ExploreEmbedded/8051_ExploreStarter8051/(list of files, cad)

Other CAD files:
Code/KeilSampleCodes/01a-LedBlinking/Objects/main.obj
Code/KeilSampleCodes/02a-SwitchLed/Objects/main.obj
Code/KeilSampleCodes/05b-Lcd_4bit_UpCounter/Objects/main.obj
Code/KeilSampleCodes/06c-UART_Tx_String/Objects/main.obj
Code/KeilSampleCodes/06d-UART_Tx_Numbers/Objects/main.obj
Code/KeilSampleCodes/06e-UART_String_RxTx_Lcd/Objects/main.obj
Code/KeilSampleCodes/09b-RTC_DS1307_LCD/Objects/main.obj
Code/KeilSampleCodes/05a-Lcd_4bit_Display/Objects/main.obj
Code/KeilSampleCodes/05c-Lcd_4bit_Scrolling/Objects/main.obj
Code/KeilSampleCodes/06a_UART_Tx_Char/Objects/main.obj
Code/KeilSampleCodes/07a-ADC_UART/Objects/main.obj
Code/KeilSampleCodes/Starter8051BoardTest/Objects/main.obj
Code/KeilSampleCodes/07b-Adc_RawValue_Voltage/Objects/main.obj
Code/KeilSampleCodes/07c-ADC_LM35_TempSensor/Objects/main.obj
Code/KeilSampleCodes/07e-ADC_Temperature_LCD/Objects/main.obj
Code/KeilSampleCodes/09a-RTC_DS1307_UART/Objects/main.obj
Code/KeilSampleCodes/10a-GLcd_Test/main.OBJ
Code/KeilSampleCodes/06b-UART_Rx_Tx_Lcd/Objects/main.obj
Code/KeilSampleCodes/07d-ADC_LCD/Objects/main.obj
Code/KeilExampleCodes/01a-LedBlinking_Example/01a-LedBlinking_Example.OBJ
Code/KeilExampleCodes/02a-SwitchLed_Example/02a-SwitchLed_Example.OBJ
Code/KeilExampleCodes/05a-Lcd_4bit_Display/gpio.obj
Code/KeilSampleCodes/05a-Lcd_4bit_Display/Objects/lcd.obj
Code/KeilSampleCodes/05c-Lcd_4bit_Scrolling/Objects/lcd.obj
Code/KeilSampleCodes/06a_UART_Tx_Char/Objects/delay.obj
Code/KeilSampleCodes/06b-UART_Rx_Tx_Lcd/Objects/delay.obj
Code/KeilSampleCodes/06e-UART_String_RxTx_Lcd/Objects/uart.obj
Code/KeilSampleCodes/07a-ADC_UART/Objects/uart.obj
Code/KeilSampleCodes/07b-Adc_RawValue_Voltage/Objects/uart.obj
Code/KeilSampleCodes/07c-ADC_LM35_TempSensor/Objects/adc.obj
Code/KeilSampleCodes/07d-ADC_LCD/Objects/adc.obj
Code/KeilSampleCodes/07e-ADC_Temperature_LCD/Objects/lcd.obj
Code/KeilSampleCodes/09a-RTC_DS1307_UART/Objects/i2c.obj
Code/KeilSampleCodes/09b-RTC_DS1307_LCD/Objects/gpio.obj
Code/KeilSampleCodes/10a-GLcd_Test/glcd.obj
Code/KeilSampleCodes/Starter8051BoardTest/Objects/lcd.obj
Code/KeilExampleCodes/05a-Lcd_4bit_Display/delay.obj
Code/KeilSampleCodes/05a-Lcd_4bit_Display/Objects/delay.obj
Code/KeilSampleCodes/05b-Lcd_4bit_UpCounter/Objects/lcd.obj
Code/KeilSampleCodes/05c-Lcd_4bit_Scrolling/Objects/gpio.obj
Code/KeilSampleCodes/06a_UART_Tx_Char/Objects/uart.obj
Code/KeilSampleCodes/06b-UART_Rx_Tx_Lcd/Objects/lcd.obj
Code/KeilSampleCodes/06c-UART_Tx_String/Objects/uart.obj
Code/KeilSampleCodes/06d-UART_Tx_Numbers/Objects/uart.obj
Code/KeilSampleCodes/07a-ADC_UART/Objects/delay.obj
Code/KeilSampleCodes/07b-Adc_RawValue_Voltage/Objects/adc.obj
Code/KeilSampleCodes/07c-ADC_LM35_TempSensor/Objects/delay.obj
Code/KeilSampleCodes/07d-ADC_LCD/Objects/lcd.obj
Code/KeilSampleCodes/07e-ADC_Temperature_LCD/Objects/gpio.obj
Code/KeilSampleCodes/09a-RTC_DS1307_UART/Objects/rtc.obj
Code/KeilSampleCodes/10a-GLcd_Test/logo.obj
Code/KeilSampleCodes/Starter8051BoardTest/Objects/gpio.obj
Code/KeilExampleCodes/05a-Lcd_4bit_Display/lcd.obj
Code/KeilSampleCodes/05b-Lcd_4bit_UpCounter/Objects/gpio.obj
Code/KeilSampleCodes/06b-UART_Rx_Tx_Lcd/Objects/gpio.obj
Code/KeilSampleCodes/06d-UART_Tx_Numbers/Objects/delay.obj
Code/KeilSampleCodes/06e-UART_String_RxTx_Lcd/Objects/gpio.obj
Code/KeilSampleCodes/07b-Adc_RawValue_Voltage/Objects/delay.obj
Code/KeilSampleCodes/07c-ADC_LM35_TempSensor/Objects/uart.obj
Code/KeilSampleCodes/07d-ADC_LCD/Objects/delay.obj
Code/KeilSampleCodes/07e-ADC_Temperature_LCD/Objects/adc.obj
Code/KeilSampleCodes/09a-RTC_DS1307_UART/Objects/delay.obj
Code/KeilSampleCodes/09b-RTC_DS1307_LCD/Objects/lcd.obj
Code/KeilSampleCodes/10a-GLcd_Test/delay.obj
Code/KeilExampleCodes/05a-Lcd_4bit_Display/05a-Lcd_4bit_Display.OBJ
Code/KeilSampleCodes/05a-Lcd_4bit_Display/Objects/gpio.obj
Code/KeilSampleCodes/05b-Lcd_4bit_UpCounter/Objects/delay.obj
Code/KeilSampleCodes/05c-Lcd_4bit_Scrolling/Objects/delay.obj
Code/KeilSampleCodes/06a_UART_Tx_Char/Objects/lcd.obj
Code/KeilSampleCodes/06b-UART_Rx_Tx_Lcd/Objects/uart.obj
Code/KeilSampleCodes/06e-UART_String_RxTx_Lcd/Objects/delay.obj
Code/KeilSampleCodes/07a-ADC_UART/Objects/adc.obj
Code/KeilSampleCodes/07d-ADC_LCD/Objects/gpio.obj
Code/KeilSampleCodes/09b-RTC_DS1307_LCD/Objects/delay.obj
Code/KeilSampleCodes/Starter8051BoardTest/Objects/uart.obj
Code/KeilSampleCodes/06a_UART_Tx_Char/Objects/gpio.obj
Code/KeilSampleCodes/06e-UART_String_RxTx_Lcd/Objects/lcd.obj
Code/KeilSampleCodes/07e-ADC_Temperature_LCD/Objects/delay.obj
Code/KeilSampleCodes/09a-RTC_DS1307_UART/Objects/uart.obj
Code/KeilSampleCodes/09b-RTC_DS1307_LCD/Objects/i2c.obj
Code/KeilSampleCodes/10a-GLcd_Test/uart.OBJ
Code/KeilSampleCodes/Starter8051BoardTest/Objects/delay.obj
Code/KeilSampleCodes/09b-RTC_DS1307_LCD/Objects/rtc.obj
