ExploreEmbedded/8051_ExploreStarter8051/Design Files/Starter_x51_USB.pdf

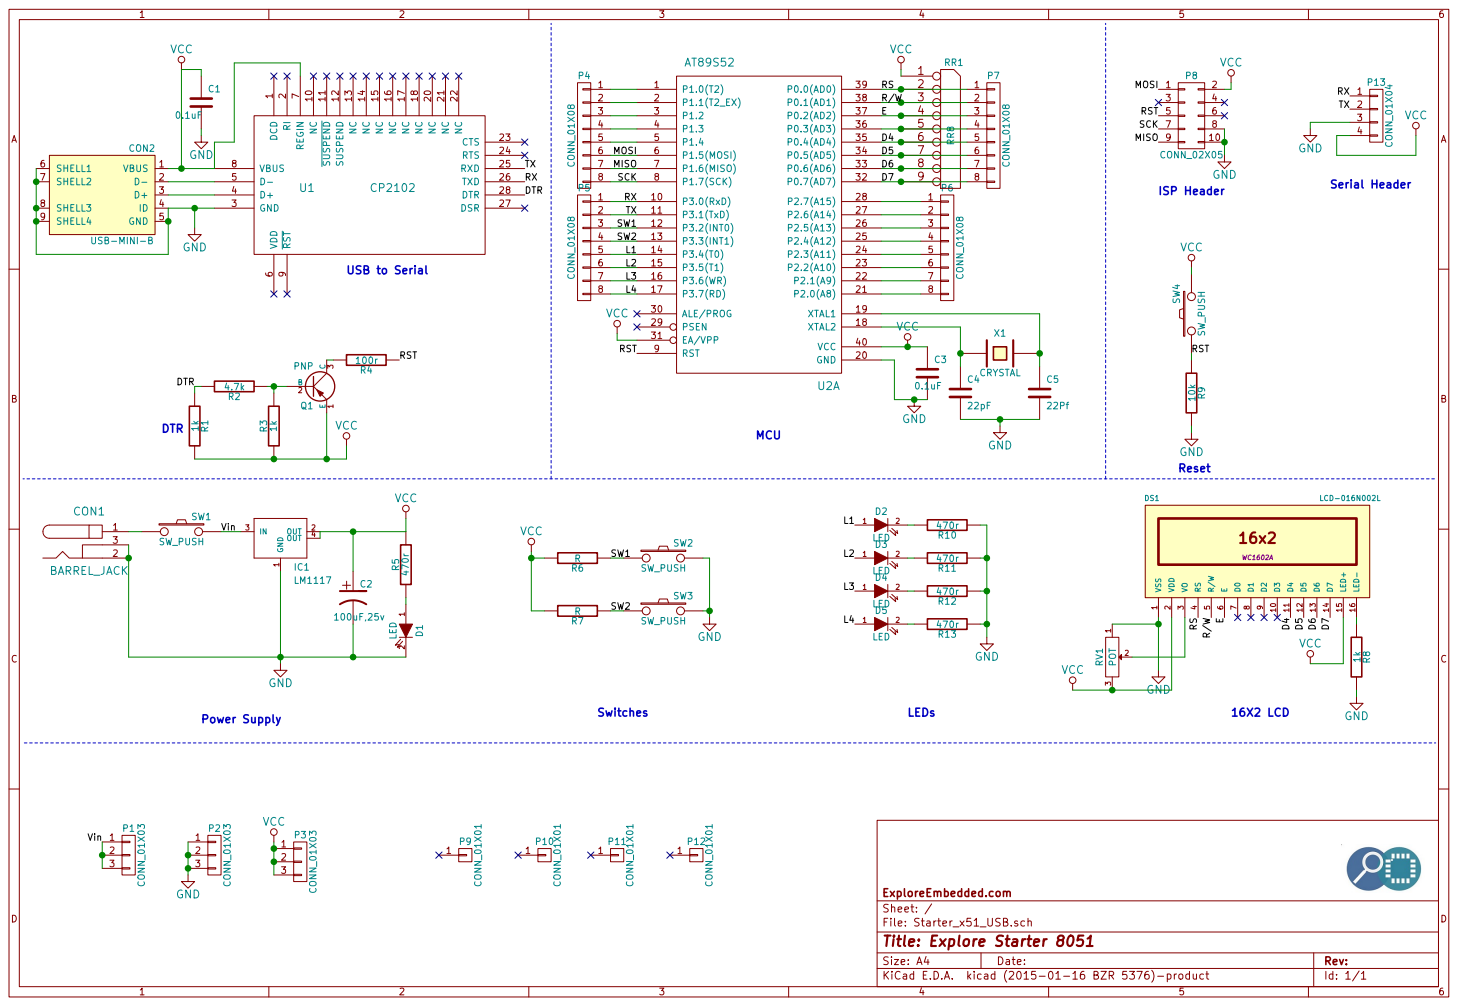
[picture p1: page 1]

9 NC 10 NC 20 SUSPEND 11 NC 21 SUSPEND 12 NC 22 NC 13 CTS 23 NC 14 RTS 24 NC 15 RXD 25 NC 16 TXD 26 NC 17 DSR 27 NC 18 DTR U1 CP2102 28 VBUS 1 D- 2 D+ 3

USB to Serial DTR

3 Q1 PNP Power Supply Switches LEDs 16X2 LCD

9 D3 10 D4 11 D5 12 D6 13 D7 14 LED+ 15 LED- 16 DS1 LCD-016N002L WC1602A GND

File: Starter_x51_USB.sch Sheet: / ExploreEmbedded.com

Id: 1/1 Title: Explore Starter 8051
