ExploreEmbedded/8051_ExploreStarter8051/(list of files, drawings)

Other design files:
Other/Tutorials fritzing diagram/7segment.fzz
