ExploreEmbedded/8051_ExploreStarter8051/Design Files/Starter_x51_USB.kicad_pcb

## KiCad design Design Files/Starter_x51_USB.kicad_pcb (2016-03-23)

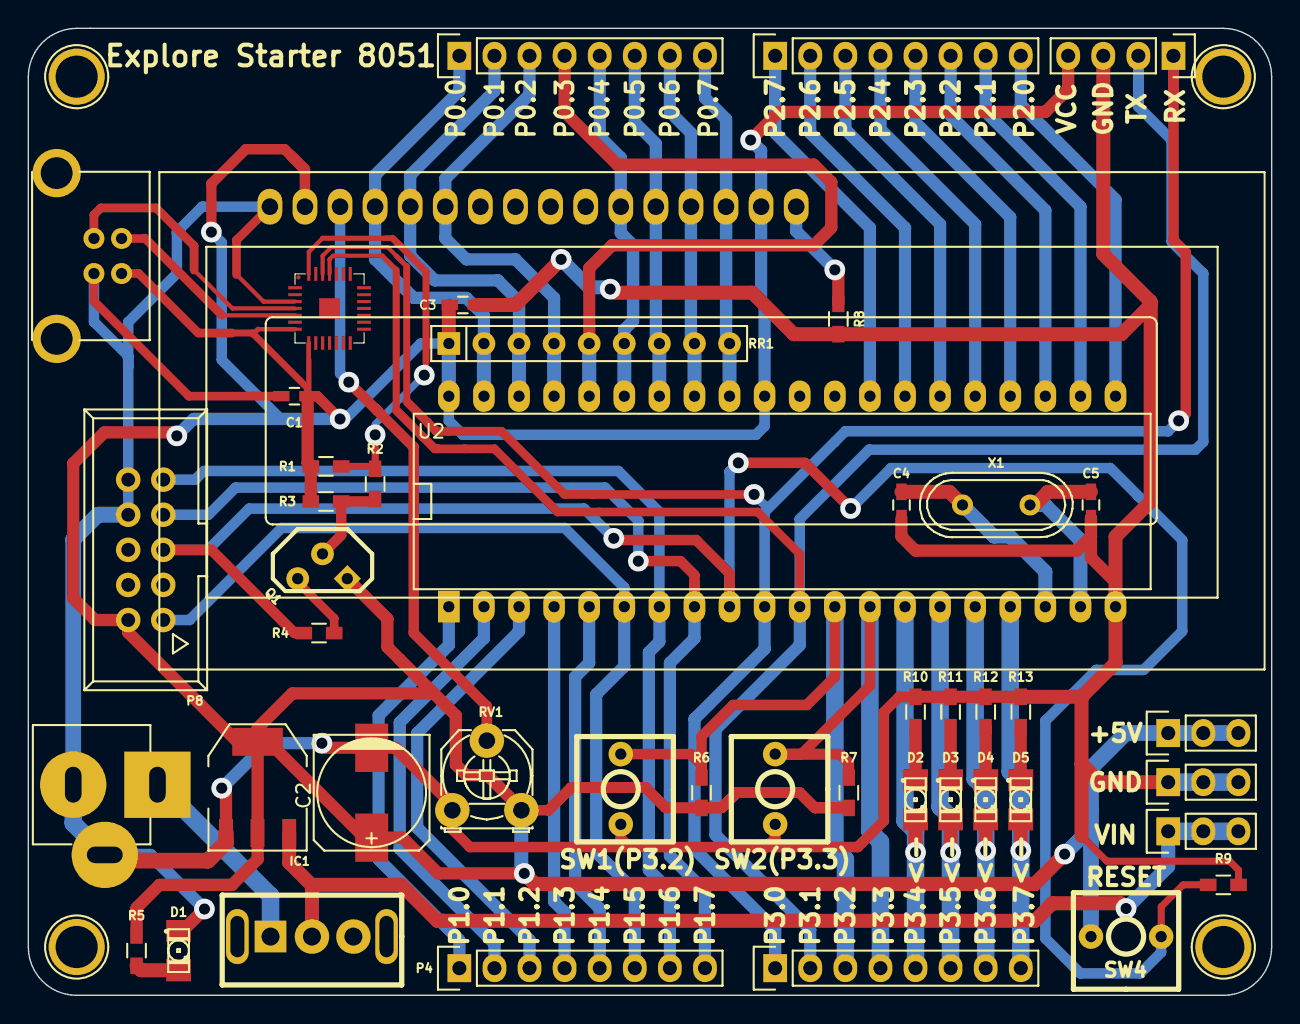
[picture p2: board Starter_x51_USB.kicad_pcb from above]

Board: 2 copper layers, 90.0 x 70.0 mm, 50 parts (0 on the bottom side), 51 nets.

Parts:
C1, C3: 0.1uF; C_0603_HandSoldering
C2: 100uF,25v; c_elec_8x10.5
C4: 22pF; C_0603_HandSoldering
C5: 22Pf; C_0603_HandSoldering
CON1: BARREL_JACK; JACK_ALIM
CON2: USB-MINI-B; USB_B
D1, D2, D3, D4, D5: LED; LED-1206_NEW
DS1: LCD-016N002L; WC1602A
IC1: LM1117; LM_1117
P1, P2, P3: CONN_01X03; Pin_Header_Straight_1x03
P4, P5, P6, P7: CONN_01X08; Pin_Header_Straight_1x08
P8: CONN_02X05; VASCH5x2
P9, P10, P11, P12: CONN_01X01; 1pin
P13: CONN_01X04; Pin_Header_Straight_1x04
Q1: PNP; BC557
R1, R3, R8: 1k; R_0603_HandSoldering
R2: 4.7k; R_0603_HandSoldering
R4: 100r; R_0603_HandSoldering
R5, R10, R11, R12, R13: 470r; R_0603_HandSoldering
R6, R7: R; R_0603_HandSoldering
R9: 10k; R_0603_HandSoldering
RR1: RR8; Resistor_Array_SIP8
RV1: POT; Potentiometer_Triwood_RM-065
SW1: SW_PUSH; SPSPT_XL_NEW
SW2, SW3, SW4: SW_PUSH; SW_PUSH_SMALL_2pin_3D_xl
U1: CP2102; cp2102_xl2
U2: AT89S52; DIP-40__600_ELL
X1: CRYSTAL; Crystal_HC49-U_Vertical

Connections:
/D4: DS1.11, P7.5, RR1.6, U2.35
/D5: DS1.12, P7.6, RR1.7, U2.34
/D6: DS1.13, P7.7, RR1.8, U2.33
/D7: DS1.14, P7.8, RR1.9, U2.32
/DTR: R1.1, R2.2, U1.28
/E: DS1.6, P7.3, RR1.4, U2.37
/L1: D2.1, P5.5, U2.14
/L2: D3.1, P5.6, U2.15
/L3: D4.1, P5.7, U2.16
/L4: D5.1, P5.8, U2.17
/MISO: P4.7, P8.9, U2.7
/MOSI: P4.6, P8.1, U2.6
/R/W: DS1.5, P7.2, RR1.3, U2.38
/RS: DS1.4, P7.1, RR1.2, U2.39
/RST: P8.5, R4.1, R9.1, SW4.1, U2.9
/RX: P5.1, P13.1, U1.26, U2.10
/SCK: P4.8, P8.7, U2.8
/SW1: P5.3, R6.1, SW2.1, U2.12
/SW2: P5.4, R7.1, SW3.1, U2.13
/TX: P5.2, P13.2, U1.25, U2.11
/Vin: IC1.3, P1.1, P1.2, P1.3, SW1.2
GND: C1.2, C2.2, C3.2, C4.2, C5.2, CON1.2, CON1.3, CON2.4, D1.2, DS1.1, IC1.1, P2.1, P2.2, P2.3, P8.8, P8.10, P13.3, R8.2, R9.2, R10.1, R11.1, R12.1, R13.1, RV1.1, SW2.2, SW3.2, U1.3, U2.20
unnamed: C4.1, U2.18, X1.1
unnamed: C5.1, U2.19, X1.2
unnamed: CON1.1, SW1.1
unnamed: CON2.2, U1.5
unnamed: CON2.3, U1.4
unnamed: D1.1, R5.1
unnamed: D2.2, R10.2
unnamed: D3.2, R11.2
unnamed: D4.2, R12.2
unnamed: D5.2, R13.2
unnamed: DS1.3, RV1.2
unnamed: DS1.16, R8.1
unnamed: P4.1, U2.1
unnamed: P4.2, U2.2
unnamed: P4.3, U2.3
unnamed: P4.4, U2.4
unnamed: P4.5, U2.5
unnamed: P6.1, U2.28
unnamed: P6.2, U2.27
unnamed: P6.3, U2.26
unnamed: P6.4, U2.25
unnamed: P6.5, U2.24
unnamed: P6.6, U2.23
unnamed: P6.7, U2.22
unnamed: P6.8, U2.21
unnamed: P7.4, RR1.5, U2.36
unnamed: Q1.2, R2.1, R3.2
unnamed: Q1.3, R4.2
VCC: C1.1, C2.1, C3.1, CON2.1, DS1.2, DS1.15, IC1.2, IC1.4, P3.1, P3.2, P3.3, P8.2, P13.4, Q1.1, R1.2, R3.1, R5.2, R6.2, R7.2, RR1.1, RV1.3, SW4.2, U1.7, U1.8, U2.31, U2.40
