ExploreEmbedded/8051_ExploreStarter8051/Code/KeilSampleCodes/07e-ADC_Temperature_LCD/main.c

/***************************************************************************************************
                                   ExploreEmbedded
****************************************************************************************************
 * File:   main.c
 * Version: 16.0
 * Author: ExploreEmbedded
 * Website: http://www.exploreembedded.com/wiki
 * Description: This file contains the program to read the temperature(LM35) from ADC channel 0 and display it on LCD.

The libraries have been tested on ExploreEmbedded development boards. We strongly believe that the
library works on any of development boards for respective controllers. However, ExploreEmbedded
disclaims any kind of hardware failure resulting out of usage of libraries, directly or indirectly.
Files may be subject to change without prior notice. The revision history contains the information
related to updates.


GNU GENERAL PUBLIC LICENSE:
    Copyright (C) 2012  ExploreEmbedded

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

Errors and omissions should be reported to codelibraries@exploreembedded.com
**************************************************************************************************/
#include "adc.h"
#include "lcd.h"

/********************************
  adc.h ADC0809 pin Connections
*********************************
adc_databus --> P2

adc_A    --> P1^0;
adc_B    --> P1^1;
adc_C    --> P1^2;
adc_ALE  --> P1^3;
adc_Start--> P1^4;
adc_EOC  --> P1^5;
adc_OE   --> P1^6;
*********************************/ 

int main() 
{
    int adcValue;
    int temp;
    
    ADC_Init();       /* Initialize the ADC module */
    
    /*Connect RS->P0.0, RW->P0.1, EN->P0.2 and data bus to P0.4 to P0.7*/
    LCD_SetUp(P0_0,P0_1,P0_2,P_NC,P_NC,P_NC,P_NC,P0_4,P0_5,P0_6,P0_7);
    LCD_Init(2,16);
    
    while(1)
    {
        adcValue = ADC_GetAdcValue(0); // Read the ADC value of channel zero where the temperature sensor(LM35) is connected
        
        /* Convert the raw ADC value to equivalent temperature with 5v as ADC reference
		       Step size of AdC= (5v/255)=19.60mv = 20mv.
		       for every degree celcius the Lm35 provides 10mv voltage change.
			     1 step of ADC=20mv=2'c, hence the Raw ADC value can be multiplied by 2 to get equivalent temp*/
        
        temp = adcValue*2; // Multiple by 2 to get the temp value.
        LCD_GoToLine(0);
        LCD_Printf("ADC0 Value:%3d \nTemp:%2d\n\r",adcValue,temp);     // Display adc value and temp LCD
    }
    
    return (0);
}
