ExploreEmbedded/8051_ExploreStarter8051/Code/KeilSampleCodes/00-libfiles/logo.c

/***************************************************************************************************
                                    ExploreEmbedded Copyright Notice    
*****************************************************************************************************
 * File:   logo.c
 * Version: 16.0
 * Author: ExploreEmbedded
 * Website: http://www.exploreembedded.com/wiki
 * Description: File contains the bitmap for sample Logos.
 * Note: The logos are just for demo purpose and all rights pertaining to these belong to the respective owners.

This code has been developed and tested on ExploreEmbedded boards.  
We strongly believe that the library works on any of development boards for respective controllers. 
Check this link http://www.exploreembedded.com/wiki for awesome tutorials on 8051,PIC,AVR,ARM,Robotics,RTOS,IOT.
ExploreEmbedded invests substantial time and effort developing open source HW and SW tools, to support consider buying the ExploreEmbedded boards.
 
The ExploreEmbedded libraries and examples are licensed under the terms of the new-bsd license(two-clause bsd license).
See also: http://www.opensource.org/licenses/bsd-license.php

EXPLOREEMBEDDED DISCLAIMS ANY KIND OF HARDWARE FAILURE RESULTING OUT OF USAGE OF LIBRARIES, DIRECTLY OR
INDIRECTLY. FILES MAY BE SUBJECT TO CHANGE WITHOUT PRIOR NOTICE. THE REVISION HISTORY CONTAINS THE INFORMATION 
RELATED TO UPDATES.
 

Permission to use, copy, modify, and distribute this software and its documentation for any purpose
and without fee is hereby granted, provided that this copyright notices appear in all copies 
and that both those copyright notices and this permission notice appear in supporting documentation.
***************************************************************************************************/

#define _audi_                 0
#define _ford_                 1
#define _puma_                 2
#define _sparx_                3
#define _intel_                5
#define _microsoft_            6
#define _nike_                 7
#define _spartans_             8
#define _tajmahal_1_           9
#define _tajmahal_2_          10
#define _titanic_             11
#define _AshokStambh_         12
#define _Camera_              13
#define _exploreEmbedded_     14
#define _PremierLeage_        15
#define _Arsenal_             16
#define _Chelsea_             17
#define _LiverPool_           18
#define _ManchesterUnited_    19
#define _SouthWalesScorpians_ 20

#define _IPL_                 21
#define _Bengaluru_           22
#define _Delhi_               23
#define _Gujrat_              24
#define _Hyderabad_           25
#define _Kolkata_             26
#define _Mumbai_              27
#define _Punjab_              28
#define _Pune_                29
#define _MakeInIndia_         30
#define _NoLogo_              99


/****************************************************************************
                Select one of the above logos to be displayed
****************************************************************************/								
#define SelectLogo _exploreEmbedded_
/***************************************************************************/





/******************************************************************************************************
                          128x64 BitMap for standard Logos 
*******************************************************************************************************/													
#if (SelectLogo == _audi_)
code const unsigned char LogoBitMap[] = {
  0xFF, 0xFF, 0xFF, 0xFF, 0xFF, 0xFF, 0xFF, 0xFF, 0xFF, 0xFF, 0xFF, 0xFF, 0x7F, 0x3F, 0x1F, 0x8F,
  0x87, 0xC7, 0xC7, 0xE3, 0xE3, 0xF3, 0xF1, 0xF1, 0xF1, 0xF1, 0xF1, 0xF1, 0xF1, 0xF1, 0xF5, 0xF3,
  0xF3, 0xEB, 0xEB, 0xDF, 0xF7, 0xBF, 0x7F, 0x7F, 0x0F, 0x8F, 0xC7, 0xC7, 0xE3, 0xE3, 0xF3, 0xF3,
  0xF1, 0xF1, 0xF1, 0xF1, 0xF1, 0xF1, 0xF1, 0xF1, 0xF3, 0xFB, 0xEB, 0xFF, 0xDF, 0xDF, 0xB7, 0xFF,
  0x5F, 0x8F, 0x87, 0xC7, 0xC7, 0xE3, 0xE3, 0xF3, 0xF1, 0xF1, 0xF1, 0xF1, 0xF1, 0xF1, 0xF1, 0xF1,
  0xF1, 0xFB, 0xFB, 0xEB, 0xFB, 0xDF, 0xFF, 0xBF, 0x7F, 0x0F, 0x0F, 0x8F, 0xC7, 0xC7, 0xE3, 0xE3,
  0xF3, 0xF3, 0xF1, 0xF1, 0xF1, 0xF1, 0xF1, 0xF1, 0xF1, 0xF1, 0xF3, 0xEB, 0xEB, 0xFF, 0xDF, 0xDF,
  0xBF, 0xEF, 0xFF, 0xFF, 0xFF, 0xFF, 0xFF, 0xFF, 0xFF, 0xFF, 0xFF, 0xFF, 0xFF, 0xFF, 0xFF, 0xFF,
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
0x7E, 0x6E, 0x6E, 0xEE, 0xEF, 0xCF, 0xCF, 0xCF, 0xCF, 0xDF, 0x9F, 0x9F, 0x1F, 0x1B, 0x1B, 0x09,
0x00, 0x00, 0x00, 0x00, 0x00, 0x00, 0x80, 0xE0, 0xF0, 0x78, 0x3E, 0x1F, 0x0F, 0x03, 0x01, 0x00,
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
};
#endif
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
