ExploreEmbedded/8051_ExploreStarter8051/(commit log)

2016-03-23 Added design Files
    [Starter_x51_USB.kicad_pcb, Starter_x51_USB.sch]
2016-05-03 Added Sample Code
    Added Sample code for 8051
    IDE:Keil
    [adc.obj, delay.obj, gpio.obj, i2c.obj, lcd.obj, main.obj, rtc.obj, uart.obj]
2016-06-15 LED blink code added
    [01a-LedBlinking_Example.OBJ]
2016-06-20 Switch LED code updated
    [02a-SwitchLed_Example.OBJ, 05a-Lcd_4bit_Display.OBJ, delay.obj, gpio.obj, lcd.obj]
2016-06-20 LCD code updated
    [05a-Lcd_4bit_Display.OBJ, delay.obj, gpio.obj, lcd.obj]
2017-07-12 BOM Generated
    [Explore Starter 8051.csv, Explore Starter 8051.xls]
2017-09-23 Added the glcd example with libraries
    [delay.obj, glcd.obj, logo.obj, main.OBJ, uart.OBJ]
